YannickTurcotte/GPSDO-YT/prep/jumper_settings.jpg

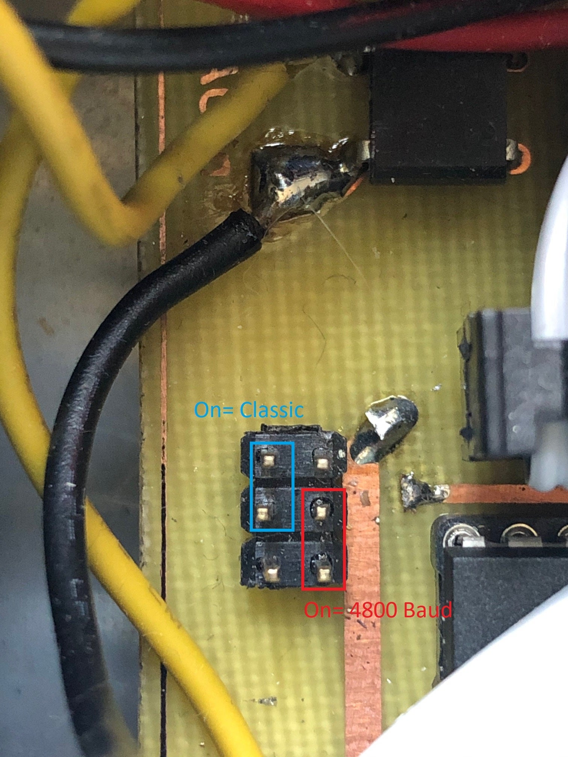
prep/jumper_settings.jpg
