YannickTurcotte/GPSDO-YT/README.md

# GPSDO-YT

A GPS‑Disciplined Oscillator on ATmega328

https://www.instructables.com/GPSDO-YT-10-Mhz-Lcd-2x16-With-LED/

Gpsdo Yannick.atsln  ---> Source file can be open with Microchip Studio 7
A lot of information is in main.asm to modify the algorithm to fit with your OCXO

The nop loop is very important. It assure to take only one cycle to enter in an interrupt.
If you bypass the loop it will works. But the count will be +- .002 instead .001

# 🧭 Overview

GPSDO‑YT is a GPS‑Disciplined Oscillator built entirely around an ATmega328 microcontroller.

It uses a 10 MHz Oven‑Controlled Crystal Oscillator (OCXO) as both the reference and the system clock, and a u‑blox NEO‑M8N GPS as the precision 1 Pulse‑Per‑Second (1PPS) source.

All timing logic and control are implemented entirely in AVR assembly, at single‑cycle precision.

---

# ⚙️ Operating Principle

- The ATmega328 runs directly from the OCXO clock, meaning the same clock being disciplined also drives the CPU.

- The GPS 1PPS signal triggers INT0, providing an external absolute reference each second.

- The firmware counts OCXO cycles between two GPS pulses to determine frequency or phase error.

- A DAC correction loop then fine‑tunes the OCXO control voltage to zero that error over long time spans.

---

# ⚡ Timing & Performance

- Latency‑balanced interrupt system: start and stop routines are fully symmetrical, so any fixed hardware latency cancels out.

- The main loop is a sequence of pure NOP instructions (NOP + RJMP pattern) ensuring a perfectly flat pipeline and zero jitter before each interrupt.

- Although the AVR core inherently takes ~4 cycles to vector an interrupt, both the start and stop paths include that delay identically — yielding a true zero‑offset measurement.

- Effective timing resolution: 100 ns per CPU cycle @ 10 MHz, delivering < 1 × 10⁻¹⁰ relative frequency stability over 1000‑second integration windows.

---

# 🧠 Software Architecture

- Pure AVR Assembly: every instruction is hand‑placed, cycle‑counted, and deterministic.

- Symmetrical ISR design: startup and stop latencies matched to within one CPU cycle.

- Modular source split into GPS, UART, LCD, DAC, and timing sections.

- In continuous reliable operation since 2017.

---

# 🔬 Design Philosophy

“Achieve precision not by adding complexity,

but by fully mastering the timing you already have.”

This project brings an 8‑bit microcontroller to the edge of its physical limits, combining analog frequency discipline (OCXO + GPS) with digital timing symmetry and sub‑cycle determinism.

---

# 🏆 Key Achievements

- Symmetrical start/stop latency: interrupt entry delay self‑cancels for perfect time‑balance.

- Deterministic timing: ±1 cycle maximum jitter — theoretical minimum for AVR.

- Minimal hardware: entirely ATmega‑based; no FPGA or timing ASIC required.

- Proven reliability: stable continuous service since 2017.

- Educational value: demonstrates high‑precision timing on an 8‑bit MCU platform.

---

# ⚖️ Practical Limits

- All meaningful software and timing optimizations on the ATmega328 have been reached.

- Running faster via PLL yields minimal benefit and may introduce phase noise.

- Further jitter reduction would require dedicated synchronous capture hardware like FPGA or CPLD.

---

# ✅ Bottom Line

GPSDO‑YT is a minimalist yet professional‑grade approach to disciplined oscillator design.

With cycle‑level symmetry, clean hardware, and hand‑tuned assembly, it achieves nanosecond‑class repeatability and stands as proof that precision engineering is possible even on an 8‑bit ATmega328.

---

# ✍️ Author

Yannick Turcotte

Electronic Technician & Precision‑Timing Enthusiast

Project started in 2017 – continuously refined since.

# Version revision

-On version 1.5 i added some code to always start counting at same time after the pulse. Like, i dont have any pluse arriving while timer overflow sub routine.
This correct an intermittent problem where between 1,000,000.006 and 1,000,000.002 were displayed.

-I also change. When you unplug the device, this one restart at phese 4 even if a config is found. SOme time the drift is to far to go in running mode directly.

-Version 1.51 i added some routine to track when the pwm overflow. In other word, when pwm arrive to 0v or 5v. Unreachable Frequency message will be display if your OCXO isn't compatible. Some OCXO have input 0-8v instead 0-5v. In this case you will need to add an op-amp to match the OCXO. See here you will find a schematic.

-Add pwm value and 16 last know frequency when pus button is pressed. Value are from newer to older. Exemple: 00FF0000010000001. Last frequency was .000 before that was .999 and so on.

-Also enhanced the frequency finding algorithm. Arrive to run mode faster than before. Now if for exemple at phase 4 you find 2000000006. Instead to drop of 0.4 hertz at each of 200s until reach 0, i multiply the difference (here 6) by the know step of 200s. ie 1/(200x152,59uv) = 32.77 So i remove 32x6 directly from pwm to target 2000000000 directly. Doing this for phase 3,4,5 (no phase 6 anymore). But if the difference is only 1. I kept the 0.4 change.

-Also remove phase 6, yes a 15 minutes less. In fact phase 6 is now phase 5. With the new finding algorithm no need to do a step of 900s anymore. We pass directly to 1000s. Now often in run mode < 1 hour.

1.52

-Version 1.52 Some users had no good results with the new algorithm. This one was suppose to be more quicker and it is. But if your ocxo isn't moving 2hz/Volt this can be a problem. So i did 2 algorithms in one. To have the classic version and quick.

For Classic, adding a jumper to have pb5 to gnd. I programmed pb4 to 0 so just add jumper between pb4 and pb5 see picture (blue jumper)

Also, one user is using an old gps module running at 4800 baud. For him just add the red jumper will change the Baud rate to 4800 instead 9600.

Remove the averaging algorithm. After 20 good know values, an average was made and the pwm was programmed with this new number.. The goal was to have better accuracy in a long run. But after many reading of results, this was more a problem than a good thing. Often after this pwm change, the frequency was plus or minus 2 instead of 0. I have better result without this.

1.53
-Ennenced antibouncing on push button
-Fix when lost and signal reappers display problem.
-Add led display on startup

1.54
-Counting LED is now blinking when is counting. Led toggle each 1024 tcnt0 overflow. Led frequency is 19,07 hz

1.55
-remove phase1,2,3,4,5 and replace it by the pwm value.

1.56
-add serial tx data to monitor with putty or other on uart.

1.57
-Change the watchdog to 2 second instead of 1s. Some user had self running message no pulse detected. The watchdog was to tight in some cases. So I change this to 2 second and add some code to track when a pulse is missing in a different way.
-In some gps module GGA code are slightly different. In the string some have ,09, other have ,9, (no zero) I added some code to fix this and now have more compatibility with different models.
-The RUN led is also now a Hit LED. This LED turn on at the first time 10,000,000.000 is Hit. (Run mode) The LED will stay on if frequency is between + or - 0.001 If not the LED will be off until the target is hit again.

1.58
-So far, at 1000 seconds gate. Code was comparing only the 2 lasts digits. It was fair enough, result should be only +- 1 or so. But it some case, bug or miscount, uC could stick on a wrong frequency if the jump is too large. Now comparison is done on the whole one billion number. No more mistake.

If a miscount of + or - .050 happen. uC will reload the last good config from eeprom and do a recount first. If result isn't fix, uC return to 1 second gate to do a full recalibration.
-Now the count LED is only flashing at 2HZ. The LED turn on IRQ0 and turn off on next IRQ0. IRQ0 is the 1 second pulse. This LED was flashing too quick and was producing harmonic.

1.59
-Auto detection of the serial speed at startup (4800 to 115200). The detected speed is saved in eeprom (address 2) and reused on next boot, so modules with other baud rates than 9600 work out of the box.
-Version displayed: 1.59q / 1.59c.

1.60
-Factorised the 8 correction blocks (phase 1 to 6, too high / too low) into one single routine (correction:) with a step table in flash (PhaseTable, 8 bytes per phase). Same behaviour as before: same steps, same unreachable detection, same run LED logic. Saved 682 bytes of flash. Phase 1-2 always use the fixed jump (like before), quick mode still applies to phase 3-6 only.
-Eeprom protection: eepromw now reads address 0-1 first and only writes when the value changed. Before, every 10,000,000.000 hit in run mode was rewriting the same 2 cells (~31,000 writes/year = 100k endurance reached in ~3 years running 24/7).
-Version displayed: 1.60q / 1.60c.

1.61
-Fixed false "hit": the hit test was only checking difference_1 (the LSB). An error of exactly 256, 512... cycles (LSB = 0) was seen as a perfect 10,000,000.000 and, in run mode, the bad config was saved to eeprom. Now a new routine (testhit) checks difference_1 to difference_5 at all 6 call sites.
-Fixed quick mode error truncation: the error magnitude was taken from frequence_1 (error mod 256). With an error of 256 cycles or more the correction jump was wrong (and a jump of exactly zero if the error was a multiple of 256, which could deadlock phase 4 after a restart with a stale eeprom config). Now the error is 16 bits (difference_2:difference_1) and the step = error x QuickLargeStep is computed in 16 bits. If the required step exceeds 65535 (bigger than the whole pwm range) it goes to Unreachable, which is the correct answer.
-CheckRunLed also checks difference_2 now, so the RUN/Hit led can't turn on for an error of 256+ cycles.
-Version displayed: 1.61q / 1.61c.
