YannickTurcotte/GPSDO-YT/(threads)

Thread 2 (2025-05-10):

OSC5A2B02 OCXO

Maurizio66blu, 2025-05-10:
Hello Yannick. Congratulations for this great project. I would like to build it using an OSC5A2B02 as OCXO. It has a regulation from 0 to 4V to regulate the output. Threfore I think I must connect AVCC of the uC to a 4V reference voltage instead of +5V. Is it enough and correct or must I do someting else?

Maurizio66blu, 2025-05-10:
I wanted to write "something" and not "someting".

YannickTurcotte, 2025-05-12:
Very good question. If your vfc of ocxo is 0-4 V yes you could try to put vcc and avcc to 4v. Same power as the ocxo.

The uc can work with 4v

Another thing you could try is to left it to 5. Pwm output will probably self adjusting accordingly by lower the vfc voltage.

Yannick

Envoyé de mon iPhone

Le 10 mai 2025 à 14:40, Maurizio66blu ***@***.***> a écrit :

[https://avatars.githubusercontent.com/u/104314565?s=20&v=4]Maurizio66blu left a comment (YannickTurcotte/GPSDO-YT#2)<https://github.com/YannickTurcotte/GPSDO-YT/issues/2#issuecomment-2869083222>

I wanted to write "something" and not "someting".

—
Reply to this email directly, view it on GitHub<https://github.com/YannickTurcotte/GPSDO-YT/issues/2#issuecomment-2869083222>, or unsubscribe<https://github.com/notifications/unsubscribe-auth/APUUZY76LLEJRYR7JI7R3CD25ZB2JAVCNFSM6AAAAAB42YY422VHI2DSMVQWIX3LMV43OSLTON2WKQ3PNVWWK3TUHMZDQNRZGA4DGMRSGI>.
You are receiving this because you are subscribed to this thread.Message ID: ***@***.***>

Maurizio66blu, 2025-05-13:
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

Hi Yannick!

You are right because AVCC must not differ more than ±0.3V from VCC, so I read in the datasheet.
Therefore it is better to left all connected to +5V, the power of this OCXO.
Another problem is that LCD does not work to +4V.

YannickTurcotte, 2025-05-13:
I didn’t check for the lcd.  You could try to left it like the schematic but add a 4v regulator just for the ocxo?

Envoyé de mon iPhone

Le 13 mai 2025 à 13:01, Maurizio66blu ***@***.***> a écrit :

[https://avatars.githubusercontent.com/u/104314565?s=20&v=4]Maurizio66blu left a comment (YannickTurcotte/GPSDO-YT#2)<https://github.com/YannickTurcotte/GPSDO-YT/issues/2#issuecomment-2877307509>

Very good question. If your vfc of ocxo is 0-4 V yes you could try to put vcc and avcc to 4v. Same power as the ocxo.

The uc can work with 4v

Another thing you could try is to left it to 5. Pwm output will probably self adjusting accordingly by lower the vfc voltage.

Yannick

Envoyé de mon iPhone

Le 10 mai 2025 à 14:40, Maurizio66blu @.***> a écrit :

[https://avatars.githubusercontent.com/u/104314565?s=20&v=4]Maurizio66blu left a comment (YannickTurcotte/GPSDO-YT#2<https://github.com/YannickTurcotte/GPSDO-YT/issues/2>)<#2 (comment)<https://github.com/YannickTurcotte/GPSDO-YT/issues/2#issuecomment-2869083222>>

I wanted to write "something" and not "someting".

—
Reply to this email directly, view it on GitHub<#2 (comment)<https://github.com/YannickTurcotte/GPSDO-YT/issues/2#issuecomment-2869083222>>, or unsubscribehttps://github.com/notifications/unsubscribe-auth/APUUZY76LLEJRYR7JI7R3CD25ZB2JAVCNFSM6AAAAAB42YY422VHI2DSMVQWIX3LMV43OSLTON2WKQ3PNVWWK3TUHMZDQNRZGA4DGMRSGI.
You are receiving this because you are subscribed to this thread.Message ID: @.***>

Hi Yannick!

You are right because AVCC must not differ more than ±0.3V from VCC, so I read in the datasheet.
Therefore it is better to left all connected to +5V, the power of this OCXO.
Another problem is that LCD does not work to +4V.

—
Reply to this email directly, view it on GitHub<https://github.com/YannickTurcotte/GPSDO-YT/issues/2#issuecomment-2877307509>, or unsubscribe<https://github.com/notifications/unsubscribe-auth/APUUZY6D7MEVFG23TJBOCQD26IQOXAVCNFSM6AAAAAB42YY422VHI2DSMVQWIX3LMV43OSLTON2WKQ3PNVWWK3TUHMZDQNZXGMYDONJQHE>.
You are receiving this because you commented.Message ID: ***@***.***>

Maurizio66blu, 2025-05-13:
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

Hi!

The OSC5A2B02 as OCXO need power to +5V while his VFC has a range from 0 to 4V.
It is not possibile to power the OCXO to +4V.

YannickTurcotte, 2025-05-13:
Ah ok… just stuck with the original schematic. Should be ok

Envoyé de mon iPhone

Le 13 mai 2025 à 14:16, Maurizio66blu ***@***.***> a écrit :

[https://avatars.githubusercontent.com/u/104314565?s=20&v=4]Maurizio66blu left a comment (YannickTurcotte/GPSDO-YT#2)<https://github.com/YannickTurcotte/GPSDO-YT/issues/2#issuecomment-2877522816>

I didn’t check for the lcd. You could try to left it like the schematic but add a 4v regulator just for the ocxo?

Envoyé de mon iPhone

Le 13 mai 2025 à 13:01, Maurizio66blu @.***> a écrit :

[https://avatars.githubusercontent.com/u/104314565?s=20&v=4]Maurizio66blu left a comment (YannickTurcotte/GPSDO-YT#2<https://github.com/YannickTurcotte/GPSDO-YT/issues/2>)<#2 (comment)<https://github.com/YannickTurcotte/GPSDO-YT/issues/2#issuecomment-2877307509>>

Very good question. If your vfc of ocxo is 0-4 V yes you could try to put vcc and avcc to 4v. Same power as the ocxo.

The uc can work with 4v

Another thing you could try is to left it to 5. Pwm output will probably self adjusting accordingly by lower the vfc voltage.

Yannick

Envoyé de mon iPhone

Le 10 mai 2025 à 14:40, Maurizio66blu @.***> a écrit :

[https://avatars.githubusercontent.com/u/104314565?s=20&v=4]Maurizio66blu left a comment (YannickTurcotte/GPSDO-YT#2<https://github.com/YannickTurcotte/GPSDO-YT/issues/2><#2<https://github.com/YannickTurcotte/GPSDO-YT/issues/2>>)<#2<https://github.com/YannickTurcotte/GPSDO-YT/issues/2> (comment)<#2 (comment)<https://github.com/YannickTurcotte/GPSDO-YT/issues/2#issuecomment-2869083222>>>

I wanted to write "something" and not "someting".

—
Reply to this email directly, view it on GitHub<#2<https://github.com/YannickTurcotte/GPSDO-YT/issues/2> (comment)<#2 (comment)<https://github.com/YannickTurcotte/GPSDO-YT/issues/2#issuecomment-2869083222>>>, or unsubscribehttps://github.com/notifications/unsubscribe-auth/APUUZY76LLEJRYR7JI7R3CD25ZB2JAVCNFSM6AAAAAB42YY422VHI2DSMVQWIX3LMV43OSLTON2WKQ3PNVWWK3TUHMZDQNRZGA4DGMRSGI.
You are receiving this because you are subscribed to this thread.Message ID: @.***>

Hi Yannick!

You are right because AVCC must not differ more than ±0.3V from VCC, so I read in the datasheet.
Therefore it is better to left all connected to +5V, the power of this OCXO.
Another problem is that LCD does not work to +4V.

—
Reply to this email directly, view it on GitHub<#2 (comment)<https://github.com/YannickTurcotte/GPSDO-YT/issues/2#issuecomment-2877307509>>, or unsubscribehttps://github.com/notifications/unsubscribe-auth/APUUZY6D7MEVFG23TJBOCQD26IQOXAVCNFSM6AAAAAB42YY422VHI2DSMVQWIX3LMV43OSLTON2WKQ3PNVWWK3TUHMZDQNZXGMYDONJQHE.
You are receiving this because you commented.Message ID: @.***>

Hi!

The OSC5A2B02 as OCXO need power to +5V while his VFC has a range from 0 to 4V.
It is not possibile to power the OCXO to +4V.

—
Reply to this email directly, view it on GitHub<https://github.com/YannickTurcotte/GPSDO-YT/issues/2#issuecomment-2877522816>, or unsubscribe<https://github.com/notifications/unsubscribe-auth/APUUZY3DGSU7FVJFNIMDNH326IZHJAVCNFSM6AAAAAB42YY422VHI2DSMVQWIX3LMV43OSLTON2WKQ3PNVWWK3TUHMZDQNZXGUZDEOBRGY>.
You are receiving this because you commented.Message ID: ***@***.***>
