YannickTurcotte/GPSDO-YT/serial.asm

;
;
;Serial routine

.equ   fosc=10000000	;Crystal frequency
Speed: ;from 4800 to 115200 on 10mhz
.db		$81,$40,$2a,$1f,$0f,$09,$04,$00
;.db $04,$09,$0f,$1f,$2a,$40,$81,$00
SerialExit:		;come here 152x by second with 256 prescaler to prevent the uC of hanging in serial speed detection
		adiw yh:yl,1
		reti
InitSerialEeprom:
		clr r17
		lds r16, SerialSpeed		;previously read by eepromr
		STORE UBRR0H, r17 
		STORE UBRR0L, r16
		load r18, UCSR0B
		cbr r18, (1<<RXEN0)			; disable receiver (this also clears the receive buffer from any characters that may have been received using the previous baud rate)
		STORE UCSR0B, r18
		ldi r16, (1<<RXEN0)|(1<<TXEN0) |(0<<RXCIE0)	; Enable receiver and transmitter, interrupt rx disabled
		STORE UCSR0B,r16 
		ldi r16, (0<<USBS0)|(3<<UCSZ00)				; Set frame format: 8data, 1stop bit 
		STORE UCSR0C,r16 
		ret
EndOfAllTry:
USART_Init:
		lds temp, SerialSpeed		;previously read by eepromr
		cpi temp, $FF				;if ff = empty need full setup
		breq NeedFullSetup
		rjmp InitSerialEeprom
NeedFullSetup:
		clr r17
		ldi r16, $81				;activating 4800 to start up
		STORE UBRR0H, r17 
		STORE UBRR0L, r16
		load r18, UCSR0B
		cbr r18, (1<<RXEN0)			; disable receiver (this also clears the receive buffer from any characters that may have been received using the previous baud rate)
		STORE UCSR0B, r18
		ldi r16, (1<<RXEN0)|(1<<TXEN0) |(0<<RXCIE0)	; Enable receiver and transmitter, interrupt rx disabled
		STORE UCSR0B,r16 
		ldi r16, (0<<USBS0)|(3<<UCSZ00)				; Set frame format: 8data, 1stop bit 
		STORE UCSR0C,r16 
		rcall seconde_tempo		;attends une 1.3s le temps de voir si le buffer recoit de quoi
		rcall tempo300ms
		load r16, UCSR0A		;regarde si ya de quoi qui a été recu par le serial
		sbrs r16, RXC0			;skip if bit in register is set
		rjmp NoSerialDetected	;rxc0 est a 0 on a rien recu
;Interupt
		ldi r16, (1<<TOIE2)			; Activer l'interruption pour l'overflow (TOIE2), this is creating an interrupt.
		store TIMSK2, r16			; Configurer le registre d'interruption pour le Timer/Counter 2
		ldi r16, (1<<cs22|1<<cs21)   ; /256 Donc 152
		store TCCR2B, r16			; Configurer le registre de contrôle du Timer/Counter 2
		call videecran
		call posi1
		ldi r31,high(data42*2)		;detecting serial		
		ldi r30,low(data42*2)
		call message
;SerialDetectingStart:
		clr xl
		ldi r31,high(speed*2)		;4800 at startup
		ldi r30,low(speed*2)
NextSpeed:
		cli
		clr yl
		inc xl
		lpm r16, Z+					;Load speed in r16
		push zh						;keep z address on stack because Z is used in messages sub routine.
		push zl
		cpi temp, $00
		breq EndOfAllTry
		clr r17 
setbaudrate:    
		STORE UBRR0H, r17 
		STORE UBRR0L, r16
		load r18, UCSR0B
		cbr r18, (1<<RXEN0)			; disable receiver (this also clears the receive buffer from any characters that may have been received using the previous baud rate)
		STORE UCSR0B, r18
		ldi r16, (1<<RXEN0)|(1<<TXEN0) |(0<<RXCIE0)	; Enable receiver and transmitter, interrupt rx disabled
		STORE UCSR0B,r16 
		ldi r16, (0<<USBS0)|(3<<UCSZ00)				; Set frame format: 8data, 1stop bit 
		STORE UCSR0C,r16 

;We received something.
		cpi xl, 1			;if x = 1 speed = 4800
		brne Onestpasa4800
		rcall posi2
		rcall effaceligne
		rcall posi2
		ldi r31,high(data43*2)  ;4800		
		ldi r30,low(data43*2)
		rcall message

Onestpasa4800:
		cpi xl, 2			;if x = 2 speed = 9600
		brne Onestpasa9600
		rcall posi2
		rcall effaceligne
		rcall posi2
		ldi r31,high(data44*2)  ;9600		
		ldi r30,low(data44*2)
		rcall message

Onestpasa9600:
		cpi xl, 3
		brne Onestpasa14400
		rcall posi2
		rcall effaceligne
		rcall posi2
		ldi r31,high(data45*2)  ;14400		
		ldi r30,low(data45*2)
		rcall message

Onestpasa14400:
		cpi xl, 4
		brne Onestpasa19200
		rcall posi2
		rcall effaceligne
		rcall posi2
		ldi r31,high(data46*2)  ;19200		
		ldi r30,low(data46*2)
		rcall message

Onestpasa19200:
		cpi xl, 5
		brne Onestpasa38400
		rcall posi2
		rcall effaceligne
		rcall posi2
		ldi r31,high(data47*2)  ;38400		
		ldi r30,low(data47*2)
		rcall message

Onestpasa38400:
		cpi xl, 6
		brne Onestpasa57600
		rcall posi2
		rcall effaceligne
		rcall posi2
		ldi r31,high(data48*2)  ;57600		
		ldi r30,low(data48*2)
		rcall message

Onestpasa57600:
		cpi xl, 7
		brne Onestpasa115200
		rcall posi2
		rcall effaceligne
		rcall posi2
		ldi r31,high(data49*2)  ;115200		
		ldi r30,low(data49*2)
		rcall message
		;rjmp check_if_ok
Onestpasa115200:
		pop zl		;unstack speed address if next tour.
		pop zh
		clr yl
		sei			;active l'interupt counter2 overflow
check_if_ok:	;$GPGGA pour neo 6m MAIS GNGGA sur neo 8M Donc je regarde pour seulement GGA
RXs: ; Wait for data to be received
		cpi yl, 255				;timeout detection. 152 for 1 second. 
		breq NextSpeed1
		load r17,UCSR0A		 
		sbrs r17,RXC0			;This flag bit is set when there are unread data in the receive buffer and cleared when the receive buffer is empty. 1 = unread
		rjmp RXs				;donc loop ici jusqu'au temps que rxc0 vaut 1
		;sbrc r17,FE0				;this bit is set if there is a frame error reading the character
		;rjmp NextSpeed1
		lds r16, UDR0			; Get and return received data from buffer 
		cpi temp, $47	;G
		brne check_if_ok
RXs1: ; Wait for data to be received
		cpi yl, 255	
		breq NextSpeed1
		load r17,UCSR0A		 
		sbrs r17,RXC0			
		rjmp RXs1			
		;sbrc r17,FE0				;this bit is set if there is a frame error reading the character
		;rjmp NextSpeed1			
		lds r16, UDR0			
		cpi temp, $47	;G
		brne check_if_ok
RXs2: ; Wait for data to be received
		cpi yl, 255		
		breq NextSpeed1
		load r17,UCSR0A		 
		sbrs r17,RXC0			
		rjmp RXs2		
		;sbrc r17,FE0				;this bit is set if there is a frame error reading the character
		;rjmp NextSpeed1
		lds r16, UDR0
		cpi temp, $41	;A
		brne check_if_ok
		;GGA as been detected Speed is found
		cli
		clr r16
		store TIMSK2, r16      ; stop counter and interrupt
		store TCCR2B, r16
		;eeprom strore
		rcall EepromSerialWrite	;ecris byte to eeprom address2
		rcall Seconde_tempo		;to Display the speed detected longer
		ret	;all good
NextSpeed1: rjmp NextSpeed

NoSerialDetected:
		pop zl		;unstack speed address before the return command
		pop zh
		clr R16  ; turn off int overflow counter 2
		store TIMSK2, r16
		clr temp   ;stop counter2. Il a été activé dans Usart_Init
		store TCCR2B, temp
		rcall videecran
		rcall posi1
		ldi r31,high(data52*2) ;no serial com		
		ldi r30,low(data52*2)
		rcall message
		rcall posi2
		ldi r31,high(data53*2) ;detected 		
		ldi r30,low(data53*2)
		rcall message
		clr r17
		ldi r16, $40			;No serial but we activate the default speed at 9600 if TX is used to monitor it on computer
		STORE UBRR0H, r17
		STORE UBRR0L, r16
		rcall seconde_tempo
		rcall seconde_tempo
		rcall seconde_tempo
		ret

RX: ; Wait for data to be received
		load r17,UCSR0A		 
		sbrs r17,RXC0			;This flag bit is set when there are unread data in the receive buffer and cleared when the receive buffer is empty. 1 = unread
		rjmp RX					;donc loop ici jusqu'au temps que rxc0 vaut 1
		lds r16, UDR0			; Get and return received data from buffer 
		ret 

TX: ; Wait for empty transmit buffer 
		load r17,UCSR0A         ;Load into R17 from SRAM UCSR0A. The UDRE0 Flag indicates if the transmit buffer (UDR0) is ready to receive new data. If UDRE0 is one,
		sbrs r17,UDRE0         ;the buffer is empty, and therefore ready to be written.. Skip next instruction If Bit Register is set 
		rjmp TX 
		STORE UDR0,r16		   ; Put data (r0) into buffer, sends the data 
		ret

;Ramasse le nombre de satellite et le met dans sateiilteh,l
checkgpgga:	;$GPGGA pour neo 6m MAIS GNGGA sur neo 8M Donc je regarde pour seulement GGA
		wdr
		rcall rx
		cpi temp, $47	;G
		brne checkgpgga
		rcall rx
		cpi temp, $47	;G
		brne checkgpgga
		rcall rx
		cpi temp, $41	;A
		brne checkgpgga
;ici on a detecter $GPGGA on doit rammaser le nombre de satellite
		clr r18
kjkj:		;on compte 7 virgules. Ensuite on lit le nombre de satellites.
		rcall rx
		cpi temp, $2C	;,
		brne kjkj
		inc r18
		cpi r18, $07
		brne kjkj		;compte 7 virgules
;ici s'en vienne les 2 nombres ascii. Exemple 31, 32 pour 12.
;Addition de code pour gerer les gps module qui envois 9 au lieu de 09.
		rcall rx
		sts satelliteh, temp
		rcall rx
		sts satellitel, temp		;ici le nombre de satellites est en ascii dans satelliteh:satellitel  exemple 31:32 pour afficher 12.
		cpi temp, $2c				;regarde si nous avous recu 9 virgule au lieu de 09. 2c = ,
		breq pasmoduleublox
		ret
pasmoduleublox:
		lds temp, satelliteh		;prend 9
		sts satellitel, temp		;on le met dans le low
		ldi temp, $30				
		sts satelliteh, temp		;et on met 30 dans le high pour afficher le 0 ---- > 09
		ret

;*********************************************************************************************************
;************affichesatellite*********************************************************************************************
affichesatellite:
		load r16, UCSR0A	;regarde si ya de quoi qui a été recu par le serial
		sbrs r16, RXC0		;skip if bit in register is set
		ret					;rxc0 est a 0 on a rien recu
;on a recu de quoi sur le serial
		lds temp, affichesatelliteflag
		cpi temp, $01
		breq onpeut
		ret
onpeut:
		adiw yh:yl, $01	;incremente le compteur du wait car on pert ici une seconde.
		rcall checkgpgga	;on ramasse le nombre de satellite
		rcall posi2
		ldi r31,high(data30*2)  ;sat locked = 
		ldi r30,low(data30*2)			
		rcall message
		lds temp, satelliteh
		rcall afficheascii
		rcall tx
		lds temp, satellitel
		rcall afficheascii
		rcall tx
		rcall nextline
		call SatelliteLedDriver
		ret
;*********************************************************************************************************
;*********************************************************************************************************
;S=12
affichesatellite2:
		load r16, UCSR0A	;regarde si ya de quoi qui a été recu par le serial
		sbrs r16, RXC0
		ret					;rxc0 est a 0 on a rien recu
		rcall checkgpgga	;on ramasse le nombre de satellite
		rcall posisat
		ldi temp, $53		; S
		rcall afficheascii
		call tx
		ldi temp, $3d		; =
		rcall afficheascii
		call tx
		lds temp, satelliteh
		rcall afficheascii
		call tx
		lds temp, satellitel
		rcall afficheascii
		call tx
		ldi temp, $2c		;,
		call tx
		call SatelliteLedDriver
		ret
;*********************************************************************************************************
;*********************************************************************************************************
SatelliteLedDriver:
;dois comparer si on a plus que 3 sat et allumer le led sinon le fermer..
		lds temp, satelliteh	;39 2c
		subi temp, $30
		lsl temp
		lsl temp
		lsl temp
		lsl temp
		lds r17, satellitel
		subi r17, $30
		add temp, r17
		cpi temp, $3
		brge onallumeleled22
		;sinon on ferme le led
		call SatLedOff
		ret
onallumeleled22:
		call SatLedOn
		ret

;*********************************************************************************************************
;*********************************************************************************************************
;*********************************************************************************************************
;*********************************************************************************************************
;$GPGGA,hhmmss.ss,llll.ll,a,yyyyy.yy,a,x,xx,x.x,x.x,M,x.x,M,x.x,xxxx*hh
afficheheureposition:
;affiche heure pour 10 secondes
		rcall videecran
		call nextline
		load r16, UCSR0A	;regarde si ya de quoi qui a été recu par le serial
		sbrs r16, RXC0		;skip if bit in register is set
		rjmp nosat					;rxc0 est a 0 on a rien recu pas de signal
		ldi r26, 10
afseconde:
		call nextline
		rcall checkgpggahp	;ramasse les valeur (heure)
		rcall posi1
		lds temp, heureh
		rcall afficheascii
		call tx
		lds temp, heurel
		rcall afficheascii
		call tx
		ldi temp, $3A		; :
		rcall afficheascii
		call tx
		lds temp, minuteh
		rcall afficheascii
		call tx
		lds temp, minutel
		rcall afficheascii
		call tx
		ldi temp, $3A		; :
		rcall afficheascii
		call tx
		lds temp, secondeh
		rcall afficheascii
		call tx
		lds temp, secondel
		rcall afficheascii
		call tx
		rcall espace
		call espaceserial
		ldi temp, $55	;U
		rcall afficheascii
		call tx
		ldi temp, $54	;T
		rcall afficheascii
		call tx
		ldi temp, $43	;C
		rcall afficheascii
		call tx
attendprochaineseconde:
		load r16, UCSR0A	;regarde si ya de quoi qui a été recu par le serial
		sbrs r16, RXC0		;skip if bit in register is set
		rjmp attendprochaineseconde				;rxc0 est a 0 on a rien recu
		dec r26
		brne afseconde
;le temps vien d'etre afficher 10 seconde maintenant latitude et longitude
		rcall videecran
		call nextline
		ldi r26, 10 ;pour 10 seconde
debutdeaffichagelatitudelongitude:
;affiche position pour 10 secondes
		rcall ramassegga	;ramasse la string gga au complet incluant l'heure
		rcall posi1
		call nextline
		ldi zh, high(gga)	;adresse de RAM $240 dans Z
		ldi Zl, low(gga)
		ldi r18, 2	;on passe 2 virgule pour se rendre a la latitude. On passe par dessus l'heure
aflatitude:	
		ld	r0, z+			;charge r0 avec le contenu de l'adresse que pointe z
		mov temp, r0	;
		cpi temp, $2c	;compare avec virgule
		brne aflatitude
		dec r18
		brne aflatitude
;debut latitude
		ld	r0, z+			;4
		mov temp, r0	;
		rcall afficheascii
		call tx
		ld	r0, z+			;6
		mov temp, r0	;
		rcall afficheascii
		call tx
		ldi temp, $27	;`
		rcall afficheascii
		call tx
suitelatitude:
		ld	r0, z+			;
		mov temp, r0	;compare avec virgule.... pourquoi ? parce que dans différent module il n'y a pas toujours le meme nombres de chiffre apres le point.
		cpi temp, $2c ;,
		breq emisphere
		rcall afficheascii
		call tx
		rjmp suitelatitude
emisphere:
		rcall espace
		call espaceserial
		ld	r0, z+			;on ecris N ou S
		mov temp, r0	;
		rcall afficheascii
		call tx
		rcall posi2
		call nextline
		ld	r0, z+		;passe virgule
		ld	r0, z+	
		mov temp, r0	;
		rcall afficheascii		;0
		call tx
		ld	r0, z+	
		mov temp, r0
		rcall afficheascii		;7
		call tx
		ld	r0, z+	
		mov temp, r0
		rcall afficheascii		;2
		call tx
		ldi temp, $27			;`
		rcall afficheascii
		call tx
nextline2:
		ld	r0, z+				;on affiche le reste jusqua la virgule.
		mov temp, r0
		cpi temp, $2c
		breq nextlinefini
		rcall afficheascii
		call tx
		rjmp nextline2
nextlinefini:
		rcall espace
		call espaceserial
		ld	r0, z+				;W ou E
		mov temp, r0
		rcall afficheascii
		call tx
		call nextline
		dec r26					;decremene 26 et on recommence sinon fini
		brne debutdeaffichagelatitudelongitude2
		ret
debutdeaffichagelatitudelongitude2:
		rjmp debutdeaffichagelatitudelongitude
nosat:
		call nextline
		rcall posi1
		ldi r31,high(data36*2)  	;P 1 1 sec
		ldi r30,low(data36*2)
		rcall message
		ret

;****************************************************************************************************************************************************************************************
;****************************************************************************************************************************************************************************************
;****************************************************************************************************************************************************************************************

;check heure seulement

checkgpggahp:	;$GPGGA pour neo 6m MAIS GNGGA sur neo 8M Donc je regarde pour seulement GGA
;checkgga heure position et store dans memoire heure et position
;$xxGGA,123519,4807.038,N,01131.000,E,1,08,0.9,545.4,M,46.9,M,,*47
		wdr
		rcall rx
		cpi temp, $47	;G
		brne checkgpggahp
		rcall rx
		cpi temp, $47	;G
		brne checkgpggahp
		rcall rx
		cpi temp, $41	;A
		brne checkgpggahp
		clr r18
kjkj1:		;on compte 1 virgules.
		rcall rx
		cpi temp, $2C	;,
		brne kjkj1
		inc r18
		cpi r18, $01
		brne kjkj1		;compte 1 virgules
		;ici s'en vienne les 6 nombres ascii. Exemple 31, 32 pour 12.
		rcall rx
		sts heureh, temp
		rcall rx
		sts heurel, temp		;
		rcall rx
		sts minuteh, temp
		rcall rx
		sts minutel, temp		;
		rcall rx
		sts secondeh, temp
		rcall rx
		sts secondel, temp		;
		ret


;****************************************************************************************************************************************************************************************
;****************************************************************************************************************************************************************************************
;****************************************************************************************************************************************************************************************
ramassegga:	;$ramasse toute la string de gga. et la met dans $240 +
		wdr
		rcall rx
		cpi temp, $47	;G
		brne ramassegga
		rcall rx
		cpi temp, $47	;G
		brne ramassegga
		rcall rx
		cpi temp, $41	;A
		brne ramassegga
		;	rcall rx ;passe la virgule
		;ici on a detecter $GPGGA on doit rammaser la string
		ldi zh, high(gga)		;adresse de RAM $240 dans Z
		ldi Zl, low(gga)
prochainbytes:	
		rcall rx
		mov r0,temp
		st z+, R0							;R0 dans ce que pointe Z ici $240 en montant
		cpi temp, $24			;regarde si rx recoit $. Si oui = veut dire qu'on a ramasser gga au complet
		breq donegga
		rjmp prochainbytes
donegga:
		ret
;		46`19.81427 m. N

;**********************************************************************************************
;**********************************************************************************************
;**********************************************************************************************
affichenombreSerial: 	;affiche un nombre DCB. Exemple si 0x17 est dans temp. 17 sera affiché sur port serie
		push temp		;17	;On additionne 30 sur lsb et msb donc 17 = 31 + 37
		swap temp		;71
		andi temp, $0F	;1
		subi temp, -$30 ;31
		rcall tx
		pop temp ;17
		andi temp, $0F
		subi temp, -$30 ;31
		rcall tx
		ret
;***************************************************************************************
affichenombreSerialhigh: 	;affiche un nombre DCB. Exemple si 0x17 est dans temp. 17 sera affiché sur port serie
		push temp
		swap temp		;71
		andi temp, $0F	;1
		subi temp, -$30 ;31
		rcall tx
		pop temp
		ret
affichenombreSeriallow:
		push temp
		andi temp, $0F
		subi temp, -$30 ;31
		rcall tx
		pop temp
		ret
;***************************************************************************************
messageserial:
		lpm				;lpm = load program memory. Le contenu de l'adresse pointé par Z se retrouve dans R0
		mov temp, r0	;comparons r0 avec 04 pour vois si le message est à la fin
		cpi temp, $04
		breq finmessageserial
		mov temp, r0  	;Il faut séparer la valeur lu, exemple:(41) en 40 et 10 pour envoyer à l'afficheur
		rcall tx
		adiw ZH:ZL,1	;incremente zh,zl et va relire l'addresse suivante
		rjmp messageserial
finmessageserial:
		ret
;************************************************************************************
affichegate1ksserial:
		ldi r31,high(data37*2)  		;Gate 1000s
		ldi r30,low(data37*2)
		rcall messageserial
		ldi temp, $2c		;,
		rcall tx
		ret
;***************************************************************************************
affichegate10ksserial:
		ldi r31,high(data34*2)  		;Gate 10000s
		ldi r30,low(data34*2)
		rcall messageserial
		ldi temp, $2c		;,
		rcall tx
		ret
;***************************************************************************************
affichesatellite2serial:
		load r16, UCSR0A	;regarde si ya de quoi qui a été recu par le serial
		sbrs r16, RXC0
		ret					;rxc0 est a 0 on a rien recu
		rcall checkgpgga	;on ramasse le nombre de satellite
		ldi temp, $53		; S
		rcall tx
		ldi temp, $3d		; =
		rcall tx
		lds temp, satelliteh
		rcall tx
		lds temp, satellitel
		rcall tx
		ldi temp, $2c		;,
		rcall tx
		ret
;**************************************************************************************
nextline:
		ldi temp, $d
		rcall tx
		ldi temp, $a
		rcall tx
		ret

;**************************** affichememoireserial *************************************
;affiche le contenu tel quel. exemple si $3a est dans temp 3a sera afficher
affichememoireserial:
		push temp
		swap temp		;exemple 3A
		andi temp, $0f	;on garde le  3
		ldi r31,high(hexa*2) ;pointe l'addresse le la database dans R0
		ldi r30,low(hexa*2)	; l'addresse de mémoire;
		add ZL, temp		;augmente l'adresse pour pointer le bon chiffre (r31 et r30 constitue zh et zl)
		brcc okpasdedepassementqserial	;(branch if carry est 0) si le carry est a 1 (il y a une retenue) = plus que FF on incrémente donc zh. Sinon il passe et laisse zl normal
		inc zh
okpasdedepassementqserial:
		lpm
		mov temp,r0
		rcall tx
		pop temp
		andi temp, $0f	;on garde le  3
		ldi r31,high(hexa*2) ;pointe l'addresse le la database dans R0
		ldi r30,low(hexa*2)	; l'addresse de mémoire;
		add ZL, temp		;augmente l'adresse pour pointer le bon chiffre (r31 et r30 constitue zl et zh)
		brcc okpasdedepassement7qserial	;(branch if carry est 0) si le carry est a 1 (il y a une retenue) = plus que FF on incrémente donc zh. Sinon il passe et laisse zl normal
		inc zh
okpasdedepassement7qserial:
		lpm
		mov temp,r0
		rcall tx	;3 est afficher
		ret

espaceserial:
		push temp
		ldi temp, $20
		call tx
		pop temp
		ret
