YannickTurcotte/GPSDO-YT/(commit log)

2020-10-20 Update serial.asm
    add fix for non ublox module. was receiving satellite 9, instead 09 (0x39 0x2C instead 0x30 0x39)
    [serial.asm]
2026-10-22 v1.60 + v1.61: factorisation, protection eeprom, correction de 2 bugs
2026-10-22 gpsdo_adev: adapte au format reel du port serie (capture PuTTY de Yannick)
2026-10-25 gpsdo_adev: segmentation des vieux logs PuTTY bruts (sans horodatage)
2026-10-25 gpsdo_adev: trace PWM (DAC) sur axe secondaire + libelles de figure en anglais
2026-10-25 gpsdo_adev: pause a la fin quand lance en interactif
2026-10-25 prep/: Gpsdo.hex remis a la version courante (v1.61)
2026-11-10 gpsdo_adev: coupe de confiance de la courbe ADEV (--max-frac/--min-pairs/--full)
2026-11-11 gpsdo_adev: annotation 'reliable limit (T/3)' sur la figure
